michaelkamprath/mostek-3870-rom-dumper/(commit log)

2022-09-11 adding teensy kicad symbols
2022-10-08 updated design to using an ATMEGA1284P
    [mostek-3870-rom-dumper.kicad_sch]
2022-10-11 working design cand code for ROM dumper
    [mostek-3870-rom-dumper.kicad_sch]
2022-10-11 updated schematic notes
    [mostek-3870-rom-dumper.kicad_sch]
2022-10-12 corrected 4066 power source
    [mostek-3870-rom-dumper.kicad_sch]
2022-10-29 added MK3870 power control
    [mostek-3870-rom-dumper.kicad_sch]
2022-10-30 improved documentation
    [mostek-3870-rom-dumper.kicad_sch]
2022-11-01 adde small delay after power up
2022-11-12 added picture of dumper circuit on a breadboard
